benoitfl/EFIS-AvionicsDuino-HSI/README.md

# EFIS-AvionicsDuino
This is the software of the EFIS main module described here https://avionicsduino.com/index.php/en/efis-2/

This module is based on a PJRC Teensy 4.1 board.

# HSI Branch
This branch is made to add a HSI to this repo.
