benoitfl/EFIS-AvionicsDuino-HSI/AHRS/Electronics/AHRS_01/AHRS_01.kicad_pcb

## KiCad design AHRS/Electronics/AHRS_01/AHRS_01.kicad_pcb (2023-04-03)

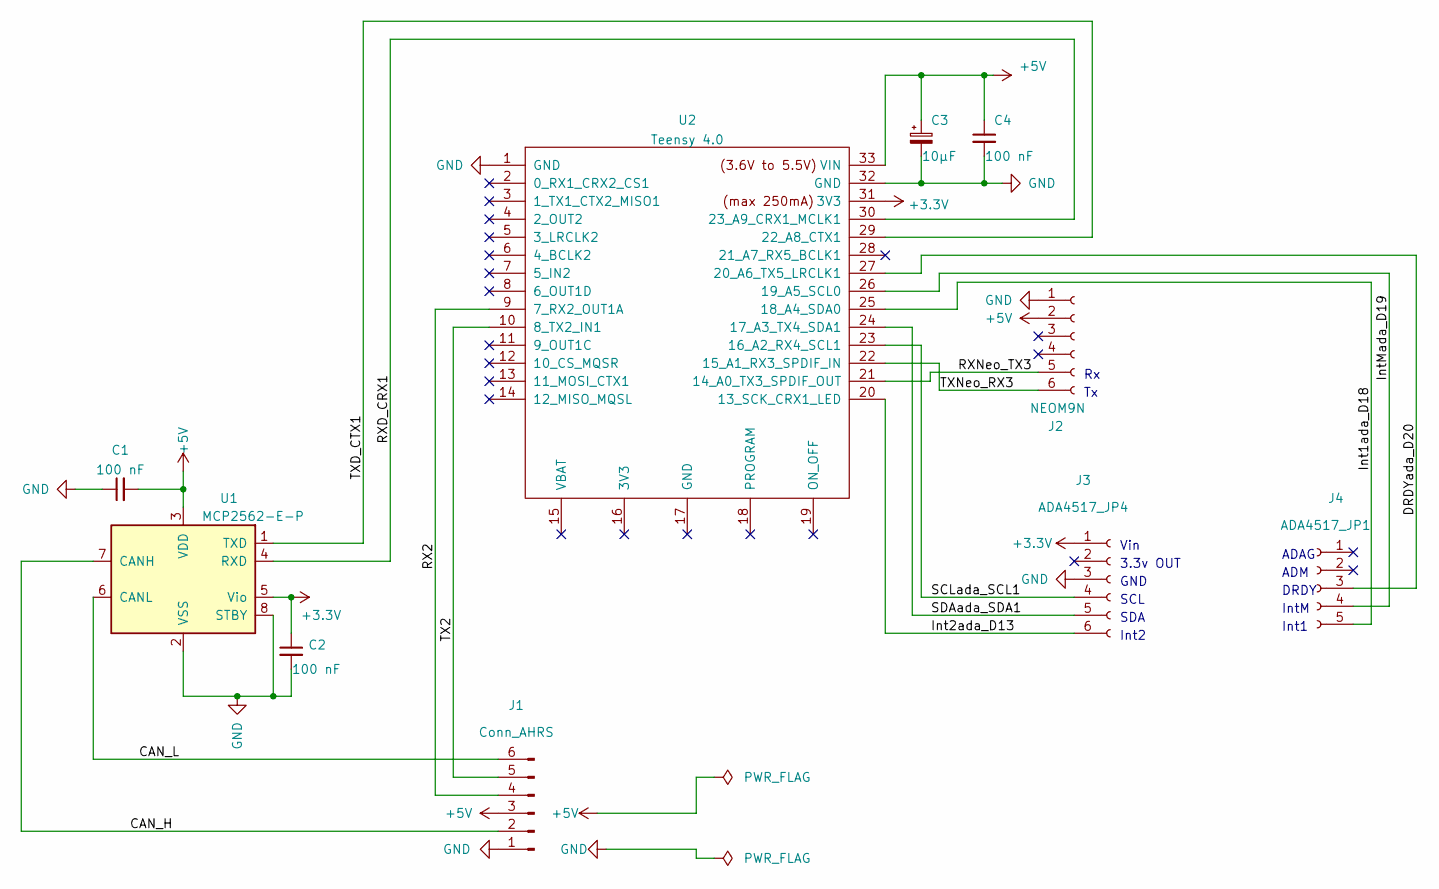
[picture p1: schematic AHRS_01.kicad_sch]

Parts:
C1, C2, C4: 100 nF; C_1206_3216Metric_Pad1.33x1.80mm_HandSolder
C3: 10µF; CP_EIA-7343-31_Kemet-D_Pad2.25x2.55mm_HandSolder
J1: Conn_AHRS; JST_EH_S6B-EH_1x06_P2.50mm_Horizontal
J2: NEOM9N; PinSocket_1x06_P2.54mm_Vertical
J3: ADA4517_JP4; PinSocket_1x06_P2.54mm_Vertical
J4: ADA4517_JP1; PinSocket_1x05_P2.54mm_Vertical
U1: MCP2562-E-P; DIP-8_W7.62mm
U2: Teensy 4.0; Teensy4FrontSide

Connections:
+3V3: C2.1, J3.1, U1.5 (Vio), U2.31 (3V3)
+5V: C1.2, C3.1, C4.1, J1.3, J2.2, U1.3 (VDD), U2.33 (VIN)
/CAN_H: J1.2, U1.7 (CANH)
/CAN_L: J1.6, U1.6 (CANL)
/DRDYada_D20: J4.3, U2.27 (20_A6_TX5_LRCLK1)
/Int1ada_D18: J4.5, U2.25 (18_A4_SDA0)
/Int2ada_D13: J3.6, U2.20 (13_SCK_CRX1_LED)
/IntMada_D19: J4.4, U2.26 (19_A5_SCL0)
/RX2: J1.4, U2.9 (7_RX2_OUT1A)
/RXD_CRX1: U1.4 (RXD), U2.30 (23_A9_CRX1_MCLK1)
/RXNeo_TX3: J2.5, U2.21 (14_A0_TX3_SPDIF_OUT)
/SCLada_SCL1: J3.4, U2.23 (16_A2_RX4_SCL1)
/SDAada_SDA1: J3.5, U2.24 (17_A3_TX4_SDA1)
/TX2: J1.5, U2.10 (8_TX2_IN1)
/TXD_CTX1: U1.1 (TXD), U2.29 (22_A8_CTX1)
/TXNeo_RX3: J2.6, U2.22 (15_A1_RX3_SPDIF_IN)
GND: C1.1, C2.2, C3.2, C4.2, J1.1, J2.1, J3.3, U1.2 (VSS), U1.8 (STBY), U2.1 (GND), U2.32 (GND)

Notes on the sheet:
DRDY
3.3v OUT
Vin
SCL
ADAG
Int1
SDA
Int2
IntM
ADM
GND

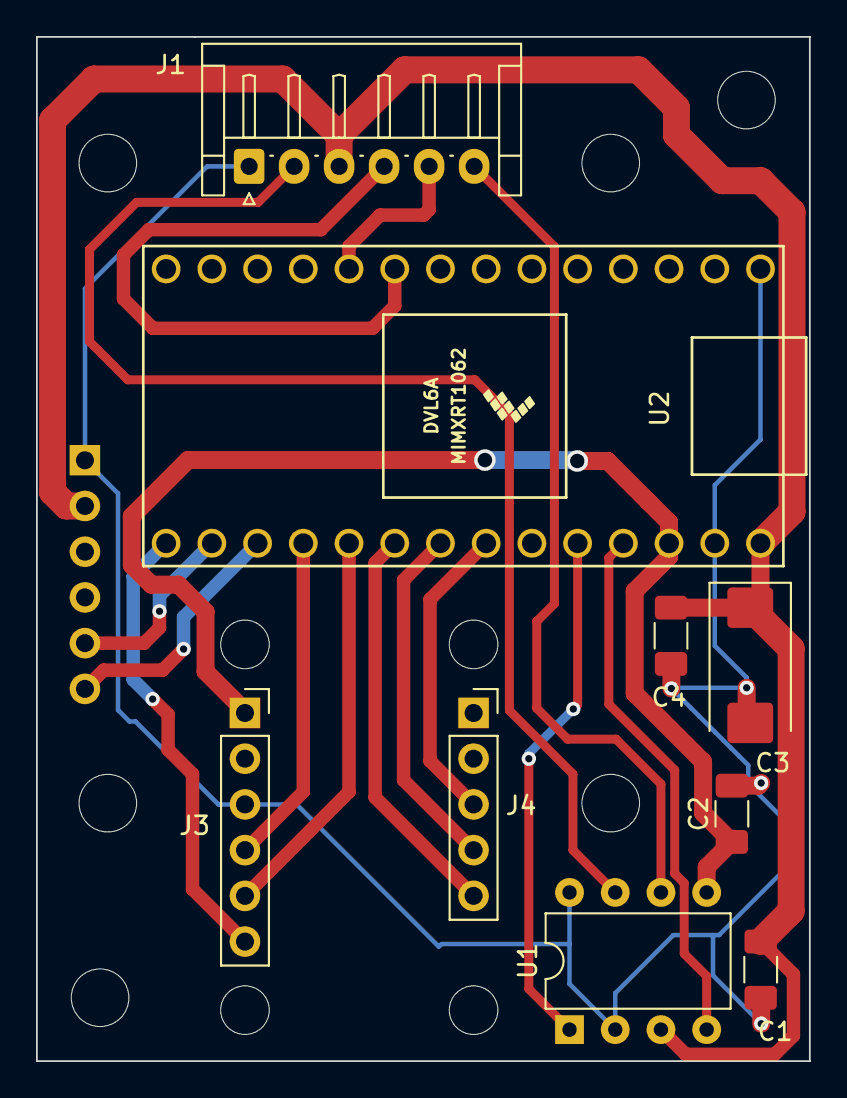
[picture p2: board AHRS_01.kicad_pcb from above]

Board: 2 copper layers, 42.9 x 56.9 mm, 10 parts (1 on the bottom side), 17 nets.
