benoitfl/EFIS-AvionicsDuino-HSI/Electronic/EFIS_V2/EFIS_V2.kicad_pcb

## KiCad design Electronic/EFIS_V2/EFIS_V2.kicad_pcb (2023-02-24)

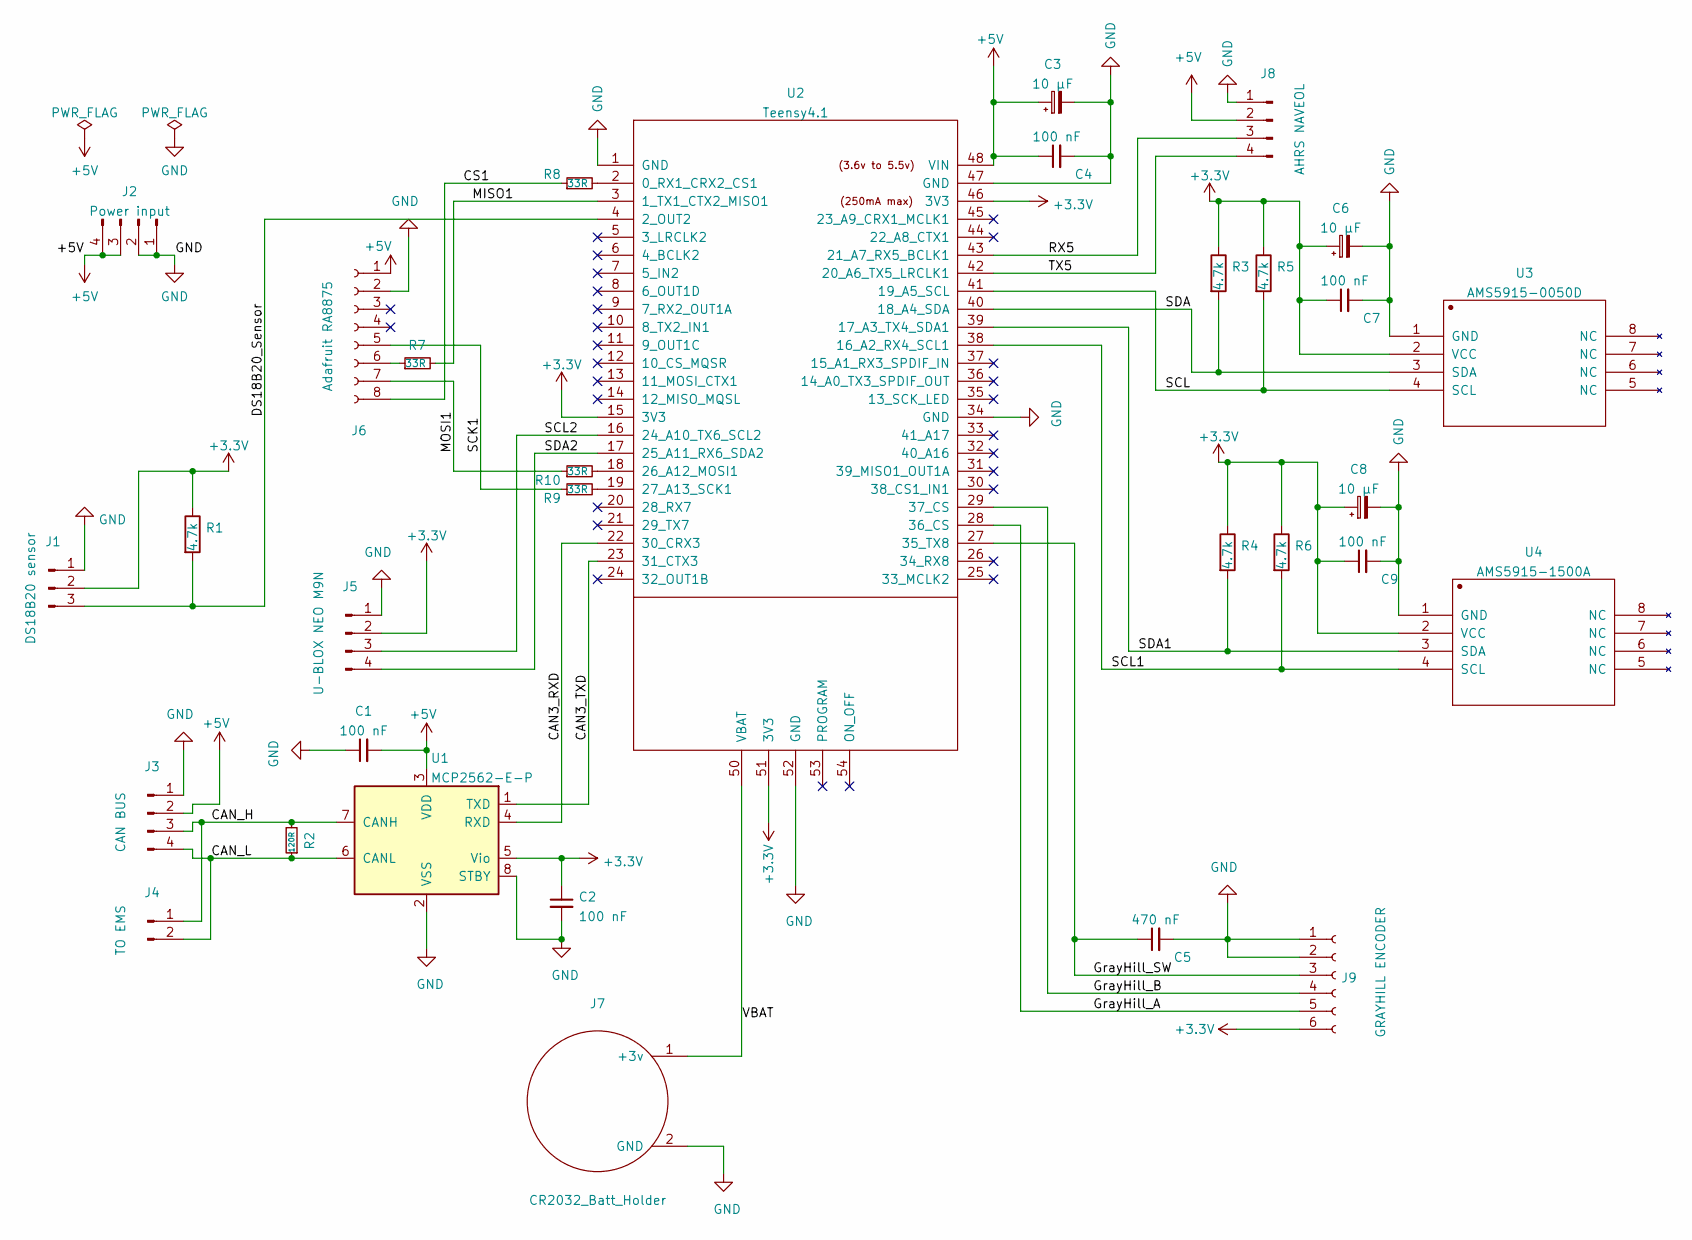
[picture p3: schematic EFIS_V2.kicad_sch, EFIS_03_KICAD6]

Parts:
C1, C2, C4, C7, C9: 100 nF; C_1206_3216Metric_Pad1.33x1.80mm_HandSolder
C3, C6, C8: 10 µF; CP_EIA-7343-31_Kemet-D_Pad2.25x2.55mm_HandSolder
C5: 470 nF; C_1206_3216Metric_Pad1.33x1.80mm_HandSolder
J1: DS18B20 sensor; Molex_KK-254_AE-6410-03A_1x03_P2.54mm_Vertical
J2: Power input; Molex_KK-254_AE-6410-04A_1x04_P2.54mm_Vertical
J3: CAN BUS; Molex_KK-254_AE-6410-04A_1x04_P2.54mm_Vertical
J4: TO EMS; Molex_KK-254_AE-6410-02A_1x02_P2.54mm_Vertical
J5: U-BLOX NEO M9N; Molex_KK-254_AE-6410-04A_1x04_P2.54mm_Vertical
J6: Adafruit RA8875; PinSocket_1x08_P2.54mm_Vertical
J7: CR2032_Batt_Holder; BatteryHolder_Keystone_103_1x20mm
J8: AHRS NAVEOL; Molex_KK-254_AE-6410-04A_1x04_P2.54mm_Vertical
J9: GRAYHILL ENCODER; 3380686
R1, R3, R4, R5, R6: 4.7k; R_1206_3216Metric_Pad1.30x1.75mm_HandSolder
R2: 120R; R_1210_3225Metric_Pad1.30x2.65mm_HandSolder
R7, R8, R9, R10: 33R; R_1206_3216Metric_Pad1.30x1.75mm_HandSolder
U1: MCP2562-E-P; DIP-8_W7.62mm
U2: Teensy4.1; Teensy41
U3: AMS5915-0050D; doublePinSocket_2x04_P2.54mm_Vertical_W15.24mm
U4: AMS5915-1500A; doublePinSocket_2x04_P2.54mm_Vertical_W15.24mm

Connections:
+3V3: C2.1, C6.1, C7.1, C8.1, C9.1, J1.2, J5.2, J9.6, R1.1, R3.1, R4.1, R5.1, R6.1, U1.5 (Vio), U2.15 (3V3), U2.46 (3V3), U2.51 (3V3), U3.2 (VCC), U4.2 (VCC)
+5V: C1.2, C3.1, C4.1, J2.3, J2.4, J3.2, J6.1, J8.2, U1.3 (VDD), U2.48 (VIN)
/CAN3_RXD: U1.4 (RXD), U2.22 (30_CRX3)
/CAN3_TXD: U1.1 (TXD), U2.23 (31_CTX3)
/CAN_H: J3.3, J4.1, R2.2, U1.7 (CANH)
/CAN_L: J3.4, J4.2, R2.1, U1.6 (CANL)
/CS1: J6.8, R8.1
/DS18B20_Sensor: J1.3, R1.2, U2.4 (2_OUT2)
/GrayHill_A: J9.5, U2.28 (36_CS)
/GrayHill_B: J9.4, U2.29 (37_CS)
/GrayHill_SW: C5.1, J9.3, U2.27 (35_TX8)
/MISO1: R7.2, U2.3 (1_TX1_CTX2_MISO1)
/MOSI1: J6.7, R10.1
/RX5: J8.3, U2.43 (21_A7_RX5_BCLK1)
/SCK1: J6.5, R9.1
/SCL: R5.2, U2.41 (19_A5_SCL), U3.4 (SCL)
/SCL1: R6.2, U2.38 (16_A2_RX4_SCL1), U4.4 (SCL)
/SCL2: J5.3, U2.16 (24_A10_TX6_SCL2)
/SDA: R3.2, U2.40 (18_A4_SDA), U3.3 (SDA)
/SDA1: R4.2, U2.39 (17_A3_TX4_SDA1), U4.3 (SDA)
/SDA2: J5.4, U2.17 (25_A11_RX6_SDA2)
/TX5: J8.4, U2.42 (20_A6_TX5_LRCLK1)
/VBAT: J7.1 (+3v), U2.50 (VBAT)
GND: C1.1, C2.2, C3.2, C4.2, C5.2, C6.2, C7.2, C8.2, C9.2, J1.1, J2.1, J2.2, J3.1, J5.1, J6.2, J7.2 (GND), J8.1, J9.1, J9.2, U1.2 (VSS), U1.8 (STBY), U2.1 (GND), U2.34 (GND), U2.47 (GND), U2.52 (GND), U3.1 (GND), U4.1 (GND)
unnamed: J6.6, R7.1
unnamed: R8.2, U2.2 (0_RX1_CRX2_CS1)
unnamed: R9.2, U2.19 (27_A13_SCK1)
unnamed: R10.2, U2.18 (26_A12_MOSI1)

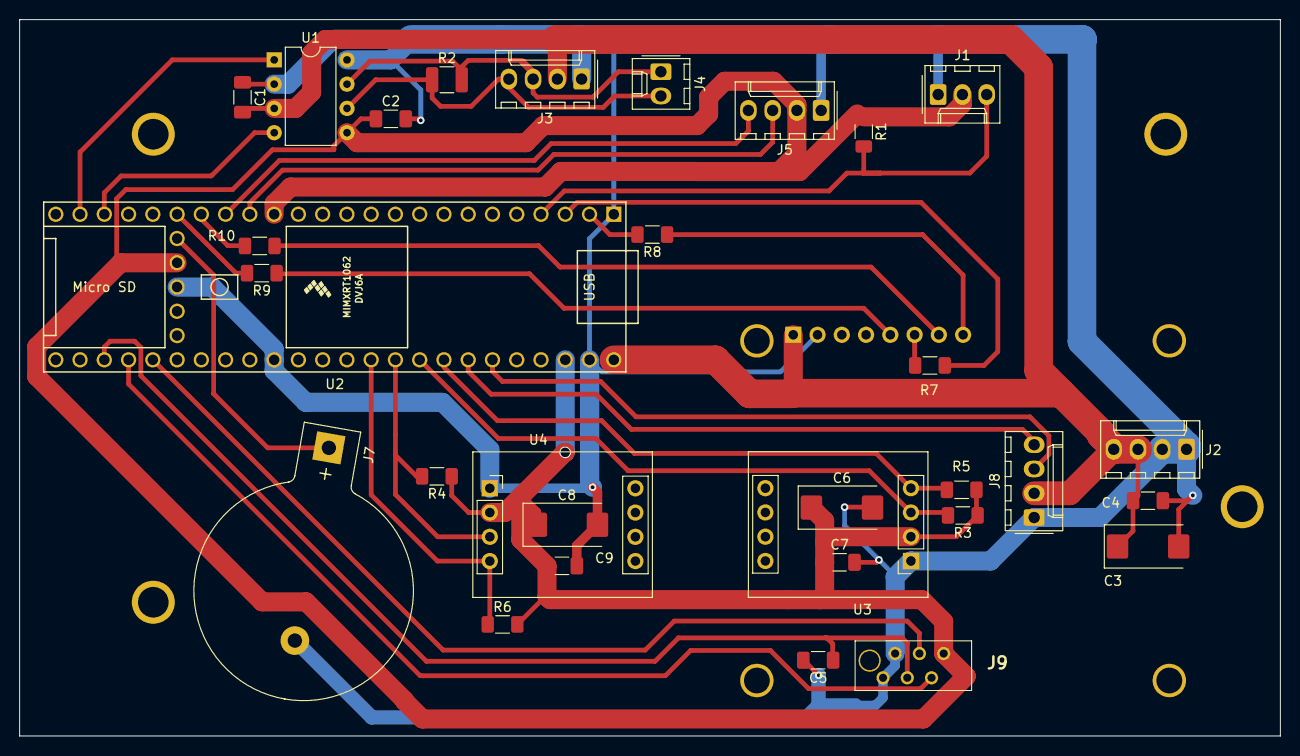
[picture p4: board EFIS_V2.kicad_pcb from above]

Board: 2 copper layers, 132.0 x 75.0 mm, 32 parts (1 on the bottom side), 28 nets.
