benoitfl/EFIS-AvionicsDuino-HSI/(commit log)

2023-02-24 Folder org.
    Adding electronics files to the repo, and reordering stuff.
    [EFIS_V2.csv, EFIS_V2.kicad_pcb, EFIS_V2.kicad_sch, EFIS_V2_BOM.xlsx]
2023-04-03 HSI Added
    Added HSI option in the menu + a HSI page
    [AHRS_01.csv, AHRS_01.kicad_pcb, AHRS_01.kicad_sch, EFIS_V2_BOM.xlsx]
