benoitfl/EFIS-AvionicsDuino-HSI/(notices)

Notices in the files:
AHRS/AHRS_AvionicsDuino_V1/AHRS_AvionicsDuino_V1.ino:
AHRS_Avionicsduino is free software: you can redistribute it and/or modify
it under the terms of the GNU General Public License as published by
the Free Software Foundation, either version 3 of the License, or
(at your option) any later version.
